dewhisna/Altura-MIDI-Theremin/README.md

# Altura-MIDI-Theremin
This is a rework of the Zeppelin Design Labs Altura-MIDI-Theremin from the ATmega328 processor to the STM32F103C8T6 BluePill.

The original source code from Zeppelin Design Labs is in the `ATmega328` folder.

The reworked source code and hardware design is in the `stm32f103c8t6` folder.
