dewhisna/Altura-MIDI-Theremin/stm32f103c8t6/hardware/LED5631B_TM1637.pdf

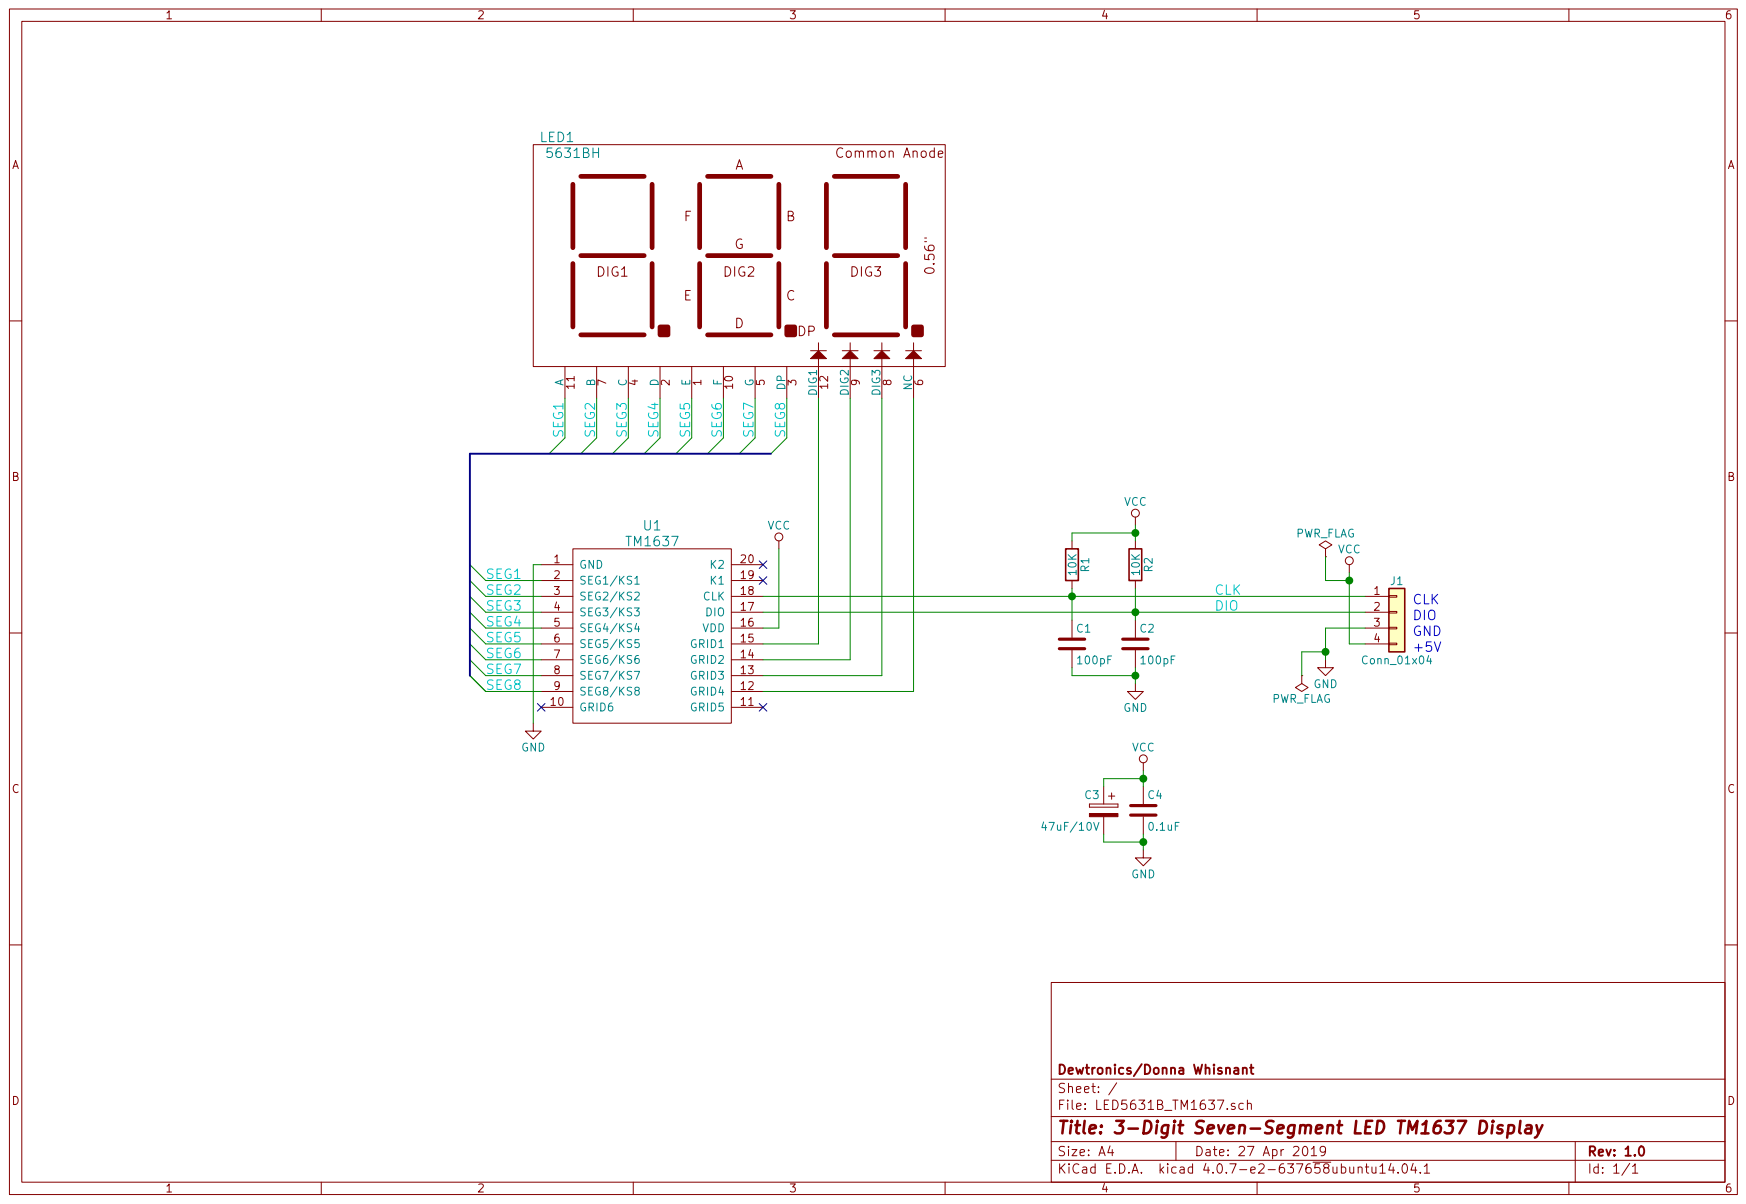
[picture p1: page 1]
