dewhisna/Altura-MIDI-Theremin/stm32f103c8t6/hardware/ThereminSTM32F103BluePill-V1.pdf

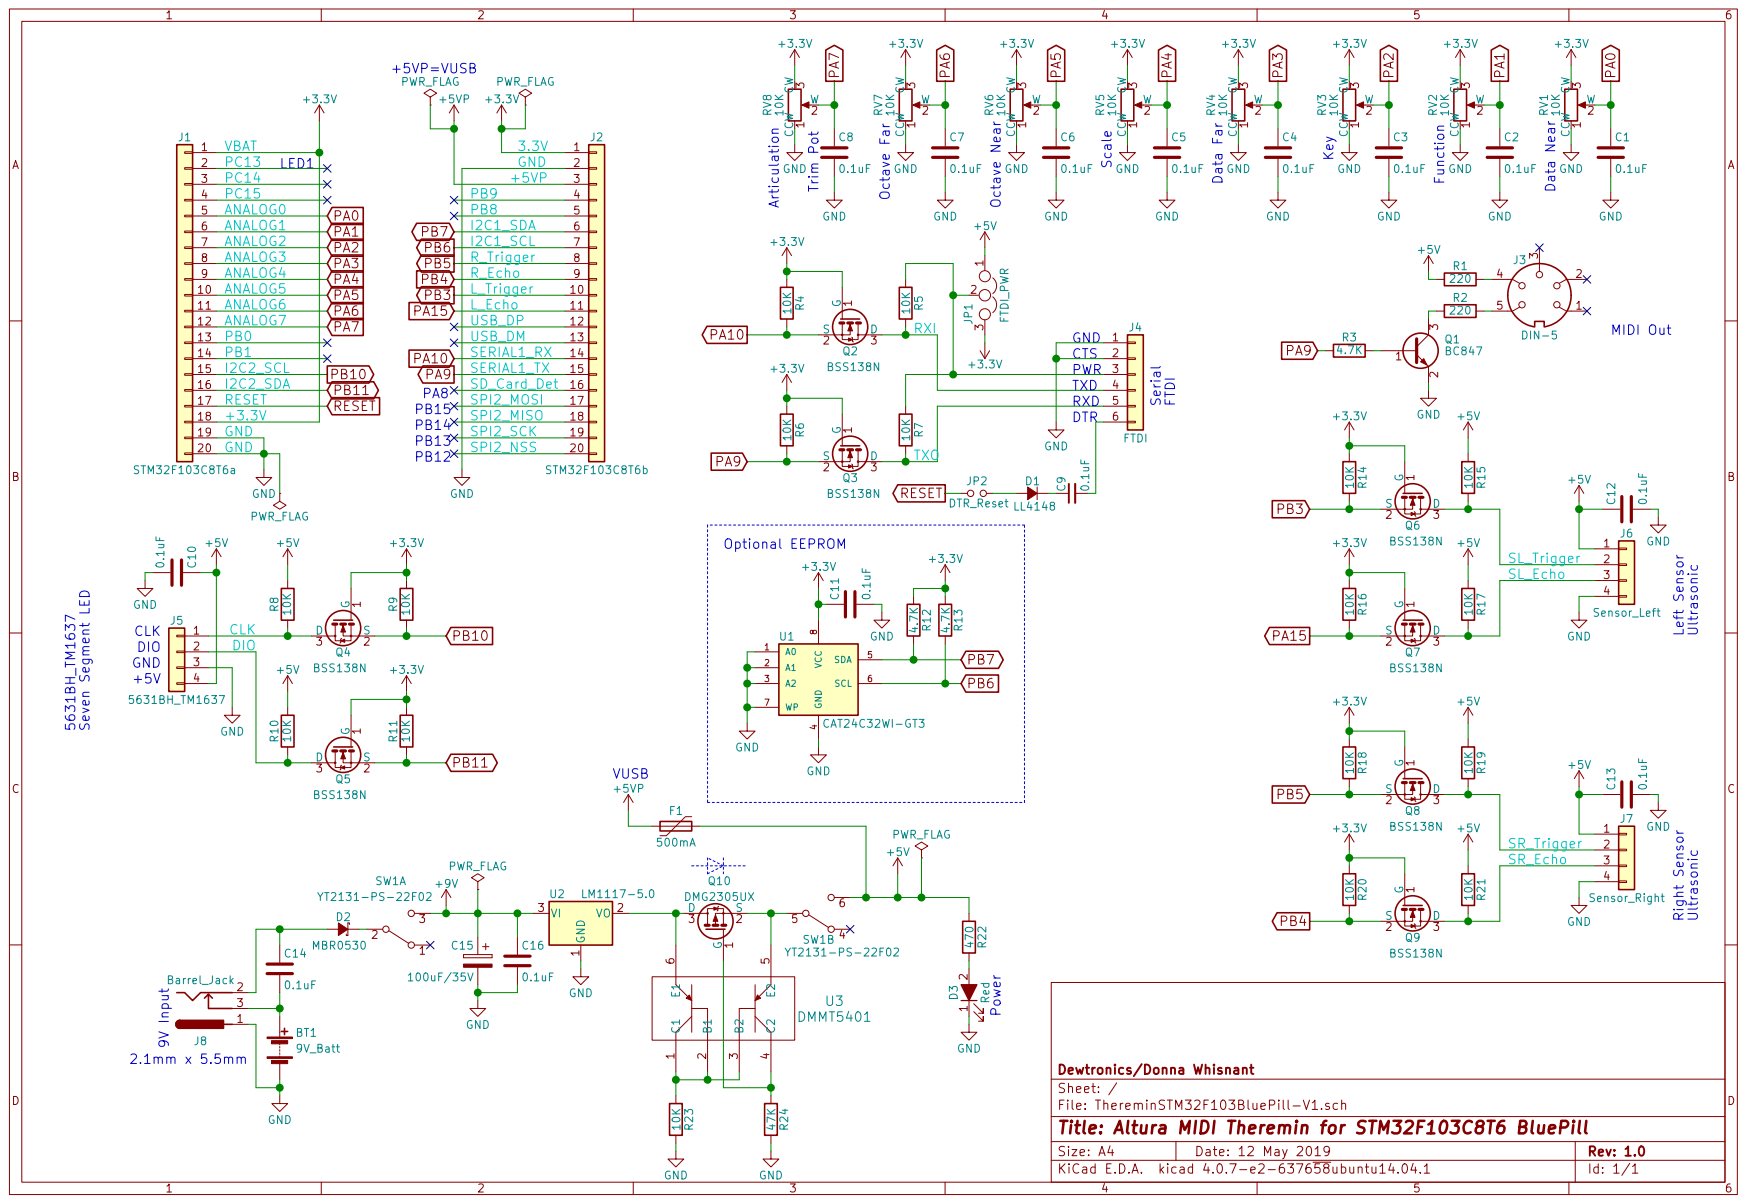
[picture p2: page 1]
