dewhisna/Altura-MIDI-Theremin/(commit log)

2019-07-04 Initial stm32f103c8t6 target setup.
2019-07-04 Fix library references, board, and platform so it will compile.
2019-07-06 Port Altura code from ATmega328 to STM32F103C8T6. It's nearly functioning except for some random issues and glitches.
    [main.cpp, timebase.cpp, timebase.h, timeout.h]
2019-07-06 Fix ADC value mapping.
    [main.cpp]
2019-07-06 Tweak sensor distances and timeouts for the faster CPU. Read the correct timer in the Timer3 IRQ. Fix Left/Right ping swap logic.
    [main.cpp]
2019-07-06 Remove general timing overflow IRQ support on timers 2 and 3. These timers can't serve as general timing, since they are tied up with PWM In mode for the ultrasonic sensors.
2019-07-06 Allow the Sensor Timer IRQs to access the sensor reading timeouts. This seems to have fixed all of the quirks in the STM32F103 port of the original ATmega328 code. Functionality now seems to be syste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
    [main.cpp]
2019-07-06 Remove unnecessary right-sensor active check in xyHandleRightSensor().
2019-07-07 Fix MIDIUSB pumpRxEvents logic.
    [main.cpp]
2019-07-07 Remove unnecessary limit checks after calls to mapADCvalue. Since mapADCvalue does correct fixed-binpoint math, the checks are not needed.
    [main.cpp]
2019-07-07 Correct parenthesis in outsidePotBuffer(). The original logic happened to work, but this is more technically correct.
    [main.cpp]
2019-07-07 Silence unused variable warnings in pumpSerialEvents(), until we actually decide to do incoming MIDI data processing.
2019-07-07 Improve PitchBend midpoint calculation in sensor range. Eliminate compile warning on mixed signed/unsigned values.
2019-07-07 Switch the timeouts to use CTimeout.
2019-07-08 Clean up the Right Sensor (NoteOn) processing.
2019-07-08 Improve sensor pinging and timing logic.
2019-07-08 Improve the sensor stabilization functions.
2019-07-08 Fix bug in setScale() for descending mode causing it to calculate wrong note values. Clean up the slope calculation in checkOctavePots().
    [main.cpp]
2019-07-08 More cleaning in handleRightSensor(). Tweak checkNoteBuffer() to special-case 0 (out of range). Make readLeftSensor() and readRightSensor() symmetric. Correct the variable types for scale extent calc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
    [main.cpp]
2019-07-08 Can't send on USBMIDI while it's currently transmitting or not ready.
2019-07-08 Add USB transmit timeout logic to keep us from hanging from inactive connection. Unfortunately, the USBComposite device doesn't actually tell us if the endpoints are connected, only the USB as a whol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
    [main.cpp]
2019-07-09 Add numbers with decimal point set to the characters. Bump overall version to 3.0.0 for STM32 release.
2019-07-09 Add hardware schematics, BOM, gerbers, and 3D Printed case files.
2019-07-09 Update README with hint on extending battery-life.
2019-09-19 Switch __always_inline for inline in timebase.h. This keeps the new __always_inline macro in Arduino_STM32 from breaking this.
2019-09-21 Switch to using gcc "__attribute__((always_inline))" in timebase.h.
